jadenchua-dot/m5stack-garden-monitor/README.md

# M5Stack Garden Monitor

A self-watering garden monitor for community and urban farming, built on the M5Stack Fire (ESP32). It reads soil moisture, air conditions and water tank level, then opens a servo-driven valve only when the plants need it.

**Demo video:** https://youtube.com/shorts/DR6Jm-IQAWk

## Problem

Singapore imports around 90% of its food, and community garden plots and balcony farms are one way residents grow some of their own. Many of these plots fail for a simple reason: uneven watering. New gardeners over-water in the first week, then forget in the second. Water gets wasted, plants die, and people give up.

## Proposed solution

A low-cost node that takes the guesswork out of watering:

1. Soil moisture sensors measure how dry each plot is.
2. An environment sensor reads air temperature, humidity and pressure, so the system can skip a cycle when the air is already humid.
3. A distance sensor above the water tank measures the water level and warns before the tank runs empty.
4. A servo releases a soft tube on a gravity-fed tank for a short, fixed time when the soil stays dry across several readings, then pinches it shut and waits through a cooldown before it can open again.
5. The Fire's screen shows live readings, and status lights show plot health at a glance.

## Hardware

| Part | Role |
|---|---|
| M5Stack Fire (ESP32) | Controller, screen, buttons, WiFi dashboard |
| Earth unit | Soil moisture |
| ENV II unit | Air temperature, humidity, pressure |
| ToF unit | Water tank level |
| Analog servo | Opens and closes the water valve |
| RGB units | Status lights |
| RFID unit | Identify a plot by tag (stretch goal) |
| Light unit | Sunlight logging (stretch goal) |
| HUB / Pb.HUB units | Share ports between units |
| Lego blocks | Planter frame, tank mount and valve arm |

An optional pump version (DC motor or small pump, 2N3904 transistor, 1 kΩ resistor, 1N4007 diode and a separate battery pack) is described in `docs/wiring.md`. It is not used in the current build.

## Wiring plan

| Port | Connected to |
|---|---|
| Port A (red, I2C) | HUB unit with ENV II and ToF |
| Port B (black) | Earth unit, analog output on GPIO36 |
| Port C (blue) | Servo, signal on GPIO17 |

The servo sweep test works on Port C. If the Fire ever resets when the servo moves, give the servo its own 5 V supply and join its ground to the Fire's GND. Pin numbers and wire colours come from M5Stack's Fire documentation, and the details are in `docs/wiring.md`.

## Setup (Windows)

1. Install Arduino IDE 2.x from arduino.cc.
2. Install the CP210x USB driver from Silicon Labs. The Fire shows up as "CP2104 USB to UART Bridge" in Device Manager.
3. In Arduino IDE open Preferences and add this URL under Additional boards manager URLs: `https://static-cdn.m5stack.com/resource/arduino/package_m5stack_index.json`
4. Install the M5Stack board package from Boards Manager, and the M5Unified library from Library Manager.
5. Select the M5Fire board and the Fire's COM port, then press Upload (the right arrow, not the Debug button).

Details and fixes for the problems I hit are in `docs/setup-windows.md`.

## Progress

- [x] Arduino IDE and M5Stack board package installed
- [x] USB driver installed, Fire detected on a COM port
- [x] `hello_fire` test sketch uploaded (screen and buttons)
- [x] I2C scan on Port A finds the ENV II and ToF units
- [x] ENV II readings in Serial Monitor (temperature, humidity, pressure)
- [x] Earth unit calibrated (dry and wet values)
- [x] Servo sweep test works on Port C
- [x] Watering logic with confirm reads and cooldown
- [x] ToF water level warning
- [x] All parts in one sketch (`garden_monitor`): soil, air, tank level, servo valve and screen
- [x] Lego frame, tank and valve arm built (9 cm bottle, servo arm pinching the tube)
- [x] Prototype demo recorded (video link at the top)
- [x] WiFi dashboard: the Fire serves a live web page of the readings

## WiFi dashboard

The Fire joins your WiFi and runs a small web server, so you can watch the
readings on a phone or laptop on the same network.

1. In `firmware/garden_monitor_wifi`, fill in `WIFI_SSID` and `WIFI_PASS` with
   your WiFi name and password. Use home WiFi or a phone hotspot; school and
   office networks often block devices from reaching each other. Do not commit
   your real password.
2. Upload the sketch. When it connects, the Fire's screen shows its address,
   like `http://192.168.1.42` (in cyan at the bottom).
3. On a device on the same WiFi, type that address into a browser. The page
   shows soil, air, water level and the valve state, and refreshes every 2
   seconds.

The page is served by the Fire itself; its HTML is embedded in the sketch, so
there is nothing else to host. If WiFi does not connect in 15 seconds, the
garden keeps running without the dashboard.

## How the demo stands in for soil

I had no soil on hand, so the demo uses water and air as the two extremes:

- Earth unit in water (reading about 2020): this stands for soil that is wet enough. The valve stays shut.
- Earth unit in air (reading 4095): this stands for soil that is too dry. After five dry readings in a row the valve opens.

The dry threshold is 3300, between the two. Real soil reads somewhere between water and air, so the threshold would need tuning in a real pot.

## Repository layout

```
firmware/
  hello_fire/          first test sketch
  i2c_scan/            lists I2C devices on Port A
  env_ii_test/         ENV II temperature, humidity and pressure
  earth_calibration/   Earth unit raw readings
  servo_test/          servo sweep on Port C
  watering_logic/      Earth unit reading opens the servo valve, with cooldown
  tof_test/            ToF distance readings
  water_level_warning/ tank level percentage and LOW WATER screen
  garden_monitor/      all parts together, with tank-low and humid-air skips
  garden_monitor_wifi/ garden_monitor plus a live web dashboard over WiFi
  valve_tuning/        buttons A and C step the servo angle, to find shut and open
docs/
  setup-windows.md     setup notes and fixes
  wiring.md            wiring notes
  build-log.md         dated notes on each stage
  images/              diagrams
```

## Notes

- AC motors are out of scope. This project uses low-voltage DC only.

Built by Jad.
