jadenchua-dot/m5stack-garden-monitor/(commit log)

2026-11-12 Add I2C scanner sketch and update progress
    Lists the devices on Port A. Ticks the I2C scan item in the README checklist and adds i2c_scan to the layout list.
2026-11-12 Record I2C scan results in wiring notes
    ENV II (0x44, 0x76) and ToF (0x29) found on Port A. 0x10, 0x68 and 0x75 belong to the Fire's internal bus.
2026-11-12 Add build log
    Dated notes on setup and the I2C scan stage.
2026-11-12 Add ENV II test sketch
    Reads temperature, humidity and pressure through the HUB on Port A and prints to Serial Monitor. Ticks the ENV II item in the README checklist.
2026-11-12 Log ENV II results
    Build log entry for stage 2 and a test log row in the wiring notes.
2026-11-12 Record Earth unit dry and water readings
    Dry in air 4095, water about 2020. Ticks the Earth unit calibration item. Damp soil reading still to do.
2026-11-12 Add Fire port wire colours from M5Stack docs
    Port C: yellow G17, white G16. Noted as not yet confirmed on my hardware.
2026-11-12 Add servo test sketch and redrawn data flow diagram
2026-11-12 Switch water control from DC motor to servo
2026-11-12 Log servo stage
2026-11-12 Add angle dial to servo valve test sketch (untested)
2026-11-12 Add Pb.HUB test with Earth unit, Angle dial and servo (untested)
2026-11-12 Ease servo moves and print reset reason, to debug Fire resets (untested)
    [watering_logic.ino]
2026-11-12 Log watering logic stage and servo frame clearance fix
2026-11-12 Log servo power fix: run from the onboard battery
2026-11-13 Add valve angle tuning sketch (untested)
2026-11-14 Add REVERSE_DIRECTION so the servo arm turns clockwise (untested)
    [garden_monitor.ino, valve_tuning.ino]
2026-11-14 Slow the valve move to 25 ms per degree to cut current spikes
2026-11-14 Set valve angles from tuning: closed 0, open 60
2026-11-14 Add Problem 7 to setup notes: wrong boot mode, fixed with the reset button
2026-11-14 Set valve angles to 10 and 85, tank distances for a 9 cm bottle
2026-11-14 Set resting valve angle to 25 degrees
2026-11-14 Log working prototype and mark the build step done
2026-11-14 Add 1 s settle delay before WiFi init to avoid brownout on boot
    [garden_monitor_wifi.ino]
2026-11-14 Fix WiFi crash: replace PROGMEM/send_P with plain string and send()
    [garden_monitor_wifi.ino]
